richsanj0-commits/micromouse-Esp-build/(list of files, cad)

Other CAD files:
cad/micromouse_assembly.step
