richsanj0-commits/micromouse-Esp-build/(commit log)

2026-10-06 Initial commit: ESP32 38-pin micromouse setup with motor forward/backward test
2026-10-06 Invert left motor direction so both motors spin forward together
    [main.cpp]
2026-10-06 Add 5-sensor ToF readings serial monitor setup
2026-10-06 Disable brownout detector and stagger sensor power-up
    [main.cpp]
2026-10-06 Add encoder calibration test with BTN1 reset
    [main.cpp]
2026-10-07 Initial commit: Setup PlatformIO, Isolated Motor, Sensor and Encoder test codes with README
2026-10-23 Add apexweb wireless web telemetry setup for alienware hotspot
2026-10-27 Add encoder CPR calibration, robot config and Fusion 3D assembly
    - examples/04_Encoder_CPR_Calibration.cpp: 4x quadrature calibration sketch
    (hand-turn trials, motor-driven N-rev verify, speed test)
    - include/robot_config.h: verified encoder pins/directions, CPR 2772 per
    wheel rev, wheel/track geometry and derived counts per cell / 90 deg turn
    - cad/micromouse_assembly.step: Fusion 360 assembly export
    - CLAUDE.md: project notes (hardware, calibration, CAD geometry)
    [micromouse_assembly.step]
2026-10-27 Fix motor/encoder directions, add ToF and drive tests, WiFi monitor
    - Verified directions: right encoder dir -1, motors forward as in 01 test
    - src/main.cpp: drive test (BTN1 fwd / BTN2 back 2000 counts) with WiFi
    terminal on port 23; credentials moved to gitignored wifi_secrets.h
    - examples/05 ToF test, examples/06 drive test
    - platformio.ini: auto-detect upload port
    - CLAUDE.md: short project notes
    [04_Encoder_CPR_Calibration.cpp, 05_ToF_Test.cpp, 06_Drive_Test.cpp, main.cpp, robot_config.h]
2026-10-28 Add 90 deg turn test, tune turn scale on the floor
    - robot_config.h: TURN_SCALE 1.14 (4 x 90 deg ends at the start heading),
    ~1750 counts per wheel per 90 deg; wheel size confirmed by drive test
    - src/main.cpp + examples/07: turn test (BTN1 right 90, BTN2 left 90)
    - CLAUDE.md: status updated
2026-10-28 Motor characterization results, 300 rpm motors, first maze test
    - Motors are 300 rpm (not 600): notes and calibration example corrected
    - examples/08: PWM sweep; L/R matched within 0-2% for PWM 50-150,
    ~60 counts/s per PWM, same forward and backward
    - src/main.cpp + examples/09: maze test for the 2x3 test maze
    (164 mm corridors): cell moves with side-wall centring, wall reading,
    left-hand run back to start, WiFi log; not run on the robot yet
    [04_Encoder_CPR_Calibration.cpp, 08_Motor_Characterization.cpp, 09_Maze_Test.cpp, main.cpp]
2026-10-28 Gyro turns and first full maze run
    - MPU6050 gyro turns (Z axis): encoder-only turns slipped 79-95 deg on the
    maze base, gyro turns land within ~1 deg (gyroBrakeDeg 4.7)
    - Gentle start on turns; fixed side-wall threshold (185 raw)
    - WiFi tuning commands: tt, kw, gb, gyro/enc, y, gd
    - Full left-hand run on the 2x3 test maze: S..6..S in 21 s, all walls
    read correctly
    [09_Maze_Test.cpp, main.cpp]
2026-10-28 Maze solver: explore to 2x2 goal, flood-fill fast run, gyro heading hold
    - BTN1 explores (depth-first, wall map) until an open 2x2 goal is found, returns to start
    - BTN2 fast run on the shortest explored path, straights joined into one move
    - Gyro heading hold + gentle side-wall nudge on straight moves
    - Centre ref from the average of both side walls, front-wall stop, stale ToF fix
    [09_Maze_Test.cpp, 10_Maze_Solver_FloodFill.cpp, main.cpp]
2026-10-31 PCB guide, right-hand priority test version
    - pcb_guide/README.md: shape, pins, power, sensors for the v2 board
    - examples/12 + main.cpp: tested solver with right/front/left priority (only change)
    - examples/11: untested stuck-turn retry version, kept for later
    [12_Maze_Solver_RightPriority.cpp, main.cpp]
2026-10-31 Mark the best solver (examples/11, video run), button fix in examples/13
    - examples/11: exact code that ran the 10x10 maze in the video (renamed from _untested)
    - examples/13 + main.cpp: same + buttons work right after power-on (WiFi in background)
    + blue LED on GPIO 2 when a press registers / during a run
    [11_Maze_Solver_BEST_video.cpp, 13_Maze_Solver_BEST_buttons.cpp, main.cpp]
2026-10-31 Lock good fast solver (examples/17): buttons only, PWM 150, smooth stops
    - 14: buttons only (no WiFi/serial), 15: PWM 120, 16: PWM 150 + one-way-in goal + no move limit
    - 17 (locked, tested OK): speed ramp, slows for front walls, half wall correction with one wall
    [14_Maze_Solver_Buttons_Only.cpp, 15_Maze_Solver_Faster.cpp, 16_Maze_Solver_Fast_OneWayGoal.cpp, 17_Maze_Solver_GOOD_fast150.cpp, main.cpp]
2026-10-31 Lock latest good solver (examples/20): PWM 150 + front-wall fix; add PWM 180 versions
    [18_Maze_Solver_Fast180.cpp, 19_Maze_Solver_Fast180_FrontSafe.cpp, 20_Maze_Solver_GOOD_latest.cpp, main.cpp]
